ETH-PBL/open-galileo-has-gnss-platform/ublox_gnss_node/Documentation/Generate Files/BOM/Bill of Materials-ublox_gnss_node(main).xlsx

Comment | Description | Designator | Footprint | LibRef | Quantity | Manufacturer | Manufacturer Part Number | Part Number | PartNumber | Manufacturer Name | Manufacturer_Name | Supplier | Supplier Part Number
ZED-X20P-00B | u-blox X20 all-band GNSS High Precision module LGA, 250 pcs/reel | U3 | ZED-F9P | ZED-X20P-00B | 1 | u-blox | ZED-X20P-00B | ZED-F9P-00B |  |  |  | DigiKey | 672-ZED-X20P-00BCT-ND
TPS2116DRLR | 1.6-V to 5.5-V, 40-mâ„ | U13, U14 | DRL0008A-MFG | TPS2116DRLR | 2 |  | TPS2116DRLR |  |  | Texas Instruments
TPD4S012DRYR | TVS DIODE 5.5V 6SON | U9, U12 | FP-DRY0006A-MFG | CMP-0326-00038-4 | 2 |  | TPD4S012DRYR
TPD4E05U06QDQARQ1 | TVS DIODE 5.5V 14V 10USON | U5 | FP-DQA0010A-MFG | CMP-04985-000004-1 | 1 | Texas Instruments | TPD4E05U06QDQARQ1
STM32H755ZIT6U | STM32H755 MCU | IC1 | QFP50P2200X2200X160-144N | STM32H755ZIT6U | 1 |  | STM32H755ZIT6U |  |  |  | STMicroelectronics
SMCJ58CA-E3/57T | TVS DIODE 58V 93.6V DO214AB | D10 | FP-95402-MFG | CMP-02577-000016-1 | 1 | Vishay Semiconductor Diodes Division | SMCJ58CA-E3/57T
SM91072AL | Telecom Transformer 1: 1 1.4Ohm Prim. DCR 1Ohm Sec. DCR 16 Terminal Gull Wing SMD Automotive | T1 | SOIC127P950X590-16N | SM91072AL | 1 | Bourns | SM91072AL |  |  |  |  | Digikey | 118-SM91072AL-ECT-ND
47R | 47Ω ±5% 1W 2512 Thick Film Chip Resistor AEC-Q200 compliant | R52, R53 | FP-RMCF2512-MFG | CMP-26527-006410-1 | 2 | Stackpole Electronics | RMCF2512JT47R0 |  |  |  |  | Avnet | RMCF2512JT47R0
NX3215SA-32.768K-STD-MUA-14 | Crystal or Oscillator - 6pF Load | Y1 | NX3215SA32768KSTDMUA8 | NX3215SA-32.768K-STD-MUA-14 | 1 |  | NX3215SA-32.768K-STD-MUA-14 |  |  |  | NDK
MX25L51245GMI-08G | NOR Flahs 512MBit QSPI Macronix | IC3 | SOIC127P1030X265-16N | MX25L51245GMI-08G | 1 |  | MX25L51245GMI-08G |  |  |  | Macronix
MB4S | BRIDGE RECT 1P 400V 500MA 4SOIC | D11 | FP-751EP-MFG | CMP-07163-000033-1 | 1 | ON Semiconductor | MB4S
M24C64-FMN6TP | EEPROM ST 64kbit I2C | IC2 | SOIC127P600X175-8N | M24C64-FMN6TP | 1 |  | M24C64-FMN6TP |  |  |  | STMicroelectronics
M12D-04PFFR-SF7003 | Conn Circular F 4 POS Solder RA Panel Mount 4 Terminal 1 Port | X1 | M12D04PFFRSF7003 | M12D-04PFFR-SF7003 | 1 | Amphenol | M12D-04PFFR-SF7003
LSM303AGRTR | IMU ACCEL/MAG I2C/SPI 12LGA | U2 | FP-LGA-12-8487206-MFG | CMP-2000-07465-2 | 1 | STMicroelectronics | LSM303AGRTR
2,2uH, 1.2A | Inductor | L2 | LQM2MPN1R0NG0L | LQM2MPN2R2MG0L | 1 |  | LQM2MPN2R2MG0L |  |  |  | Murata Electronics
LQG15HS47NJ02D | Multilayer type RF Inductor 47nH ±5% 0.72Ω 300mA 0402 | L1 | FP-LQG15HH_02-IPC_B | CMP-06042-015783-1 | 1 | Murata | LQG15HS47NJ02D |  |  |  |  | Digikey | 490-2631-6-ND
LMR43620MC3RPERQ1 | Integrated Circuit | U6 | LMR43620MC3RPERQ1 | LMR43620MC3RPERQ1 | 1 |  | LMR43620MC3RPERQ1 |  |  |  | Texas Instruments
10uF | Capacitor 10uF 0805 | C27, C32, C33, C66, C67, C74, C75 | CAPC2013X140N | LMK212AB7106MG-T | 7 |  | LMK212AB7106MG-T |  |  |  | TAIYO YUDEN
ISOUSB111DWXR | Low emissions, full and low speed isolated USB repeater 16-SSOP -40 to 125 | U8, U11 | DWX0016A | ISOUSB111DWXR | 2 | Texas Instruments | ISOUSB111DWXR |  |  |  |  | Digikey | 296-ISOUSB111DWXRCT-ND
ISM330DHCXTR | INEMO INERTIAL MODULE: ALWAYS-ON | U1 | FP-LGA-14L-DM00249496-MFG | CMP-12177-000014-1 | 1 | STMicroelectronics | ISM330DHCXTR |  |  |  |  | Digikey | 497-19784-6-ND
10uF | CAP CER 10UF 25V X5R 0603 | C8, C62, C63, C85 | FP-GRM188-0_2-IPC_C | GRM188R61E106MA73D | 4 | Murata | GRM188R61E106MA73D |  |  |  |  | Digi-Key | 490-7202-6-ND
100nF | Capacitor 100nF 0402 - storage | C31, C55, C59, C64 | CAPC1005X55X25ML05T10 | GRM155R71H104KE14J | 4 | Murata | GRM155R71H104KE14J
DNP | Capacitor 100nF 0402 - storage | C45, C47 | CAPC1005X55X25LL05T10 | GRM155R71H104KE14J | 2 | Murata | GRM155R71H104KE14J
10nF | Capacitor 10nF/50V 0402 - storage | C36, C40, C53 | GRM15x | GRM155R71H103KA88D | 3 |  | GRM155R71H103KA88D |  |  |  | Murata Electronics
100nF | [NoValue], Capacitor 100nF 0402 - storage | C2, C3, C7, C9, C37, C41, C44, C46, C50, C88 | CAPC1005X55X25LL05T10 | CMP-2008-03928-1, GRM155R71H104KE14J | 10 | Murata | GRM155R71C104KA88J, GRM155R71H104KE14J | GRM155R71C104KA88J, [NoParam]
10uF | Capacitor 10uF 0402 - storage | C39, C43 | GRM15x | GRM155R61A106ME11D | 2 |  | GRM155R61A106ME11D |  |  |  | Murata Electronics
1uF | Capacitor 1uF/35V 0402 - storage | C38, C42 | CAPC1005X70N | GRM155R6YA105KE11D | 2 |  | GRM155R6YA105KE11D |  |  |  | Murata Electronics
1uF | CAP 1uF 0402 (1005 Metric) | C1, C4 | CAPC0402(1005)60_L | CMP-1034-02114-1 | 2 | Murata | GRM155C81C105KE11D
4.7uF/50V | Capacitor 4.7uF/50V 0805 | C56 | CAPC2012X145N | GRM21BR61H475KE51L | 1 |  | GRM21BR61H475KE51L |  |  |  | Murata Electronics
EVP-AA002K | Light Touch Switch, 100 mOhm, -40 to 85 degC, 4-Pin SMD, RoHS, Tape and Reel | SW1 | PNSC-EVPAA_V | CMP-2000-06231-1 | 1 | Panasonic | EVP-AA002K |  |  |  |  | PanasonicIndustrialDevices | P13347SDKR-ND
5k1 | Resistor 5k1 0805 | R40, R42, R43, R46, R47 | ERJUP6 | ERJ-UP6D5101V | 5 |  | ERJ-UP6D5101V |  |  |  | Panasonic
10k | Resistor 10k 0805 | R13, R14, R15, R24, R25, R26, R28 | RESC2012X70N | ERJ-6GEYJ103V | 7 |  | ERJ-6GEYJ103V |  |  |  | Panasonic
10k | Resistor 10k 0402 | R41, R48, R49 | RESC1005X40X25ML05T05 | CMP-2002-00433-1 | 3 | Panasonic | ERJ-2GEJ103X
75R | Resistor 75R 0805 | R36, R37 | RESC2013X60X40NL20T25 | CMP-2001-00665-1 | 2 |  | ERA6AEB750V | ERA6AEB750V
2k2 | Resistor 2k2 0603 | R29, R30, R31, R35 | RESC2013X60X40LL20T25 | CMP-2001-00613-1 | 4 | Panasonic | ERA6AEB222V
6.8uH | Inductor 6.8uH 2.55A 43.5 MOHM | L3 | DR736R8R | DR73-6R8-R | 1 |  | DR73-6R8-R |  |  |  | Eaton
DP83826ERHBR | Ethernet Transceiver, 1-Trnsvr, PQCC32 | U4 | QFN_ERHBR_TEX | DP83826ERHBR | 1 | Texas Instruments | DP83826ERHBR |  |  |  |  | Digikey | 296-DP83826ERHBRCT-ND
0R | Resistor 0R 0402 | R2, R16, R17, R18, R22, R27, R38, R44, R51 | RESC1005X40X25LL05T10 | CMP-2002-03041-1 | 9 | Vishay Dale | CRCW04020000Z0EDHP | CRCW04020000Z0EDHP
0R | Resistor 0R 0402 | R32 | RESC1005X40X25NL05T10 | CMP-009-00183-1 | 1 | Vishay Dale | CRCW04020000Z0EDHP
DNP | Resistor 0R 0402 | R33 | RESC1005X40X25NL05T10 | CMP-009-00183-1 | 1 | Vishay Dale | CRCW04020000Z0EDHP
DNP | Resistor 0R 0402 | R39, R50 | RESC1005X40X25LL05T10 | CMP-2002-03041-1 | 2 | Vishay Dale | CRCW04020000Z0EDHP | CRCW04020000Z0EDHP
100k | 100K 0.1W 1% 0603 (1608 Metric) SMD | R54, R55 | RESC0603(1608)_N | CMP-1012-00736-1 | 2 | Vishay, [NoParam] | CRCW0603100KFKTC, [NoParam] |  |  |  |  | DigiKey, [NoParam] | CRCW0603100KFKTC-ND, [NoParam]
6k49 | Resistor 6k49 0402 1% | R34 | RESC1005X40X25NL05T05 | CMP-2002-00186-1 | 1 | Vishay Dale | CRCW04026K49FKED
10R | Chip Resistor, 10 Ohm, +/- 1%, 0.1 W, -55 to 155 degC, 0603 (1608 Metric), RoHS, Tape and Reel | R3 | RESC1608X55X25NL10T15 | CMP-1659-00008-4 | 1 | Yageo | CR0603-FX-10R0ELF |  |  |  |  | Digikey | CR0603-FX-10R0ELFCT-ND
1nF/2kV | Capacitor 1nF/2kV 3216 Isolated GND Loop Cap | C54 | CAPC3216X180N | CL31B102KJHNNNE | 1 |  | CL31B102KJHNNNE |  |  |  | SAMSUNG
DNP | Capacitor 1nF/2kV 3216 Isolated GND Loop Cap | C73, C81 | CAPC3216X180N | CL31B102KJHNNNE | 2 |  | CL31B102KJHNNNE |  |  |  | SAMSUNG
4.7uF | Capacitor 4.7uF 0603 | C68, C76 | CAPC1608X95N | CL10B475KQ8NQNC | 2 |  | CL10B475KQ8NQNC |  |  |  | SAMSUNG
1uF | Capacitor 1uF 0603 | C10, C12, C14 | CAPC1608X90N | CL10B105KP8NNNC | 3 |  | CL10B105KP8NNNC |  |  |  | SAMSUNG
220nF |  | C5 | CAPC1005X55X25NL05T05 | CMP-1034-02087-2 | 1 | Samsung | CL05B224KO5NNNC |  |  |  |  | Digikey | 1276-1176-1-ND
100nF | Capacitor 100nF 0603 | C11, C13, C16, C17, C18, C19, C20, C21, C22, C23, C24, C25, C28, C29, C30, C86, C87 | CAPC1608X90N | CC0603KRX7R7BB104 | 17 |  | CC0603KRX7R7BB104 |  |  |  | YAGEO
1uF/50V | Capacitor 1uF/50V 0801 | C57, C58, C65 | CAPC3216X110X50LL20T25 | CMP-2000-06011-1 | 3 | Kemet | C1206C105K5RACTU
1nF | Capacitor 1nF 0805 | C69, C70, C71, C72, C77, C78, C79, C80 | FP-C0805C-DN-MFG | CMP-2007-00235-2 | 8 | KEMET | C0805C102J5GACTU
100nF | Capacitor 100nF 0603 | C82, C83 | FP-C0603C-CF-MFG | CMP-2006-03061-2 | 2 | KEMET | C0603C104K5RACTU
10nF/200V | CAP 10nF 200V ±10% 0603 (1608 Metric) Thickness 1mm SMD | C51, C52 | CAPC0603(1608)100_L | CMP-1035-02328-1 | 2 | Yageo Group | C0603C103K2RAC
22pF | Capacitor 22pF 0402 | C48, C49 | C0402C104J4RACTU | C0402C220K5GACTU | 2 |  | C0402C220K5GACTU |  |  |  | KEMET
BLM18KG601SN1D | Chip Ferrite Bead, 0603, 600Ω @ 100MHz, 0.15Ω, 25%, 1.3A | FB1, FB2, FB3, FB4, FB5, FB6 | FP-BLM18-0_15-t0_8-IPC_A | CMP-0686-00581-3 | 6 |  | BLM18KG601SN1D, [NoParam]
AG9905-MTB | Power over Ethernet - PoE PD Module, Isolated DC-DC converter, IEEE802.3af compliant, Over Temp. Protection, Ind Temp. Range, Small Footprint, SMT. (Blocks not pins). | B1 | AG9905MTB | AG9905-MTB | 1 |  | AG9905-MTB |  |  | Silvertel
ABM8AIG-25.000MHZ-12-2Z-T3 | Crystal 25MHz ±20ppm (Tol) ±50ppm (Stability) 12pF FUND 50Ω Automotive 4-Pin Ultra Mini-CSMD T/R | Y2 | FP-ABM8AIG-MFG | CMP-27762-004325-2 | 1 |  | ABM8AIG-25.000MHZ-12-2Z-T3
12402012E212A | USB2.0, Type C, Top mount, CH 1.68mm, Dual Row SMT | J2, J3 | AMPHENOL_12402012E212A | 12402012E212A | 2 |  | 12402012E212A
220pF | Capacitor 220pF 0603 | C26 | CAPC1608X87N | 0603B221K500CT | 1 |  | 0603B221K500CT |  |  |  | Walsin Technology Corporation
2k2 |  | R1 | RESC1005X40X25NL05T10 | CMP-2002-07567-1 | 1 | Yageo / Phycomp |  | RC0402FR-072K2L
4.7k |  | R19, R20, R21, R23, R58, R59, R60, R61 | RESC1005X40X25LL05T05 | CMP-1011-00090-2 | 8 | Vishay Dale |  | CRCW04024K70JNTD
5.1pF |  | C34, C35 | CAPC1005X55X25NL05T10 | CMP-2008-04393-1 | 2 | Murata |  | GRM1555C1H5R1CA01D
22uF |  | C15, C60, C61 | CAPC2013X152X50ML20T25 | CMP-2007-04522-1 | 3 | AVX Interconnect / Elco |  | 0805ZD226MAT2A
33k |  | R56, R57 | RESC3116X65X40LL10T20 | CMP-2003-03510-1 | 2 | Yageo |  | RC1206JR-1033KL
100uF | Aluminum Electrolytic Capacitor, UD Series, Low Impedance, 100 uF, 25 V, + / - 20%, -55 to 105 degC, Chip Type, 6.3 x 7.7 mm D x L, Pb-Free, Reel | C84 | NIC-CAPA2-6.3X7.7_V | CMP-0687-00063-1 | 1 | Nichicon |  |  | UUD1E101MCL1GS
330R | 330R 0.063W 5% 0402 (1005 Metric) SMD | R4, R5, R6, R7, R8, R9, R10, R11, R12 | RESC0402(1005)_M | CMP-1011-00062-1 | 9 |  |  |  |  |  |  | DigiKey | CRCW0402330RJNTD-ND
LED Green | WURTH ELEKTRONIK - 150060VS75000 - LED, Green, SMD, 0603, 30 mA, 2 V, 570 nm | D1, D2, D5, D8 | WL-SMCW_0603_150060xx75000 | CMP-1426-00006-7 | 4 |  |  |  |  |  |  | RS | 8154215P
LED Red | LED Low-Power Uni-Color Red 630nm 2V 2-Pin Chip 0603(1608Metric) T/R | D4, D7 | WL-SMCW_0603_150060xx75000 | CMP-1426-00001-4 | 2 |  |  |  |  |  |  | Farnell | 150060RS75000
LED Yellow | WL-SMCW SMT Mono-Color Chip LED Waterclear | D3, D6, D9 | WL-SMCW_0603_150060xx75000 | CMP-1426-00005-3 | 3 |  |  |  |  |  |  | Farnell | 150060YS75000
MIKROBUS HOST CONN. | mikroBUS Host Socket | MIKROBUS 1 | MIKROBUS HOST CONN. SMD | MIKROBUS HOST CONN._1 | 1 |  |  |  |  |  |  | DigiKey | 1471-MIKROE-5210-ND
SMA-J-P-H-ST-EM1 | CONN SMA JACK STR 50OHM EDGE MNT | J1 | FP-SMA-J-P-H-ST-EM1-MFG | CMP-02754-000006-1 | 1 |  |  |  |  |  |  | Avnet | SMA-J-P-H-ST-EM1
TDN 5-0911WISM | TDN 5-0911WISM DC-DC Converter, 5V, 1A; No. of Outputs: 1 Output; Output Power Max: 5W; Voltage - 1: 5V; Current 1: 1A; | U7, U10 | TDN 5WISM SINGLE_TRP | TDN 5-0911WISM | 2 |  |  |  |  |  |  | DigiKey | TDN5-0911WISM-ND
testpoint |  | *7, *8, *10, *11, *13, *14, *15, *16, *17, *18, *19, *20, *21, *22, *24, *25, *26, *27, *28, *29, 2, 3, 4, 5, 6, 7, r | testpoint | testpoint | 27
