ETH-PBL/open-galileo-has-gnss-platform/ublox_gnss_node/Documentation/Generate Files/BOM/FINAL BOM/Bill of Materials-ublox_gnss_node - reduced replacements (DigiKey).xlsx

Quantity | Merged Name | Merged Number | Old PART | COMMENT | Original Part | Original Manufacturer | Matched Part Number | Matched Manufacturer | Part Match | Description | Quantity | Selected Offers | Selected Distributor | Selected Distributor SKU | Selected Offers (Distributor Link) | Stock | Unit Price, $ | Total Quantity | Total Price
2 |  | TPD4S012DRYR |  |  | TPD4S012DRYR |  | TPD4S012DRYR | Texas Instruments | Exact | IC 4CH ESD SOLUTION W/CLAMP 6SON / ESD Suppressor Diode Diode Array Uni-Dir 5.5V 6-Pin USON T/R | 2 | DigiKey 296-24244-1-ND (https://octopart.com/opatz8j6/a1) | DigiKey | 296-24244-1-ND (https://octopart.com/opatz8j6/a1) | https://octopart.com/opatz8j6/a1 | 11349 | 0.97 | 2 | 1.94
1 | STMicroelectronics | STM32H755ZIT3 | STM32H755ZIT6 | 3 has extended temp range | STM32H755ZIT3 | STMicroelectronics | STM32H755ZIT3 | STMicroelectronics | Exact | MCU 32-bit ARM Cortex M4/ARM Cortex M7 RISC 2MB Flash 1.8V/2.5V/3.3V 144-Pin LQFP Tray | 1 | DigiKey 497-STM32H755ZIT3-ND (https://octopart.com/opatz8j6/a1) | DigiKey | 497-STM32H755ZIT3-ND (https://octopart.com/opatz8j6/a1) | https://octopart.com/opatz8j6/a1 | 441 | 18.77 | 1 | 18.77
2 | SAMSUNG | CL10B475KQ8NQNC |  |  | CL10B475KQ8NQNC | SAMSUNG | CL10B475KQ8NQNC | SAMSUNG | Exact | 6.3V 4.7uF X7R 卤10% 0603 Multilayer Ceramic Capacitors MLCC - SMD/SMT ROHS | 2 | DigiKey 1276-2087-1-ND (https://octopart.com/opatz8j6/a1) | DigiKey | 1276-2087-1-ND (https://octopart.com/opatz8j6/a1) | https://octopart.com/opatz8j6/a1 | 624974 | 0.14 | 2 | 0.28
2 |  | 12402012E212A |  |  | 12402012E212A |  | 12402012E212A | Amphenol | Exact | USB Connector, USB Type C, USB 2.0, Receptacle, 24 Ways, Surface Mount, Through Hole Mount | 2 | DigiKey 664-12402012E212ACT-ND (https://octopart.com/opatz8j6/a1) | DigiKey | 664-12402012E212ACT-ND (https://octopart.com/opatz8j6/a1) | https://octopart.com/opatz8j6/a1 | 17603 | 0.67 | 2 | 1.34
2 | Yageo | RC1206JR-1033KL |  |  | RC1206JR-1033KL | Yageo | RC1206JR-1033KL | Yageo | Exact | Fixed Resistor, Metal Glaze/thick Film, 0.25W, 33000ohm, 200V, 5% +/-Tol, 100ppm/Cel, Surface Mount, 1206 | 2 | DigiKey 13-RC1206JR-1033KLCT-ND (https://octopart.com/opatz8j6/a1) | DigiKey | 13-RC1206JR-1033KLCT-ND (https://octopart.com/opatz8j6/a1) | https://octopart.com/opatz8j6/a1 | 18635 | 0.1 | 2 | 0.2
2 | Farnell | 150060RS75000 |  |  | 150060RS75000 | Farnell | 150060RS75000 | Wurth Elektronik | Similar | LED Low-Power Uni-Color Red 630nm 2V 2-Pin Chip 0603(1608Metric) T/R | 2 | DigiKey 732-4978-1-ND (https://octopart.com/opatz8j6/a1) | DigiKey | 732-4978-1-ND (https://octopart.com/opatz8j6/a1) | https://octopart.com/opatz8j6/a1 | 352667 | 0.15 | 2 | 0.3
3 | Farnell | 150060YS75000 |  |  | 150060YS75000 | Farnell | 150060YS75000 | Wurth Elektronik | Similar | LED YELLOW CLEAR 0603 SMD / Yellow 590nm LED Indication - Discrete 2V 0603 (1608 Metric) | 3 | DigiKey 732-4981-1-ND (https://octopart.com/opatz8j6/a1) | DigiKey | 732-4981-1-ND (https://octopart.com/opatz8j6/a1) | https://octopart.com/opatz8j6/a1 | 127202 | 0.15 | 3 | 0.45
1 | Avnet | SMA-J-P-H-ST-EM1 |  |  | SMA-J-P-H-ST-EM1 | Avnet | SMA-J-P-H-ST-EM1 | Samtec | Similar | RF Connectors / Coaxial Connectors 6 GHz, 50 Ohm SMA Jack or Plug, Cable Connector | 1 | DigiKey SAM8857-ND (https://octopart.com/opatz8j6/a1) | DigiKey | SAM8857-ND (https://octopart.com/opatz8j6/a1) | https://octopart.com/opatz8j6/a1 | 94715 | 2.65 | 1 | 2.65
2 | DigiKey | TDN 5-0911WISM |  |  | TDN 5-0911WISM | DigiKey | TDN 5-0911WISM | Traco Power | Similar | DC-DC Regulated Power Supply Module, 1 Output, 5W, Hybrid | 2 | DigiKey TDN5-0911WISM-ND (https://octopart.com/opatz8j6/a1) | DigiKey | TDN5-0911WISM-ND (https://octopart.com/opatz8j6/a1) | https://octopart.com/opatz8j6/a1 | 59 | 29.12 | 2 | 58.24
