ETH-PBL/open-galileo-has-gnss-platform/(list of files, drawings)

Other design files:
ublox_gnss_node/Schematic/Copy of MCU.SchDoc
ublox_gnss_node/Schematic/DCDC_Converters.SchDoc
ublox_gnss_node/Schematic/ETH.SchDoc
ublox_gnss_node/Schematic/GNSS_ZED-X20P.SchDoc
ublox_gnss_node/Schematic/IndicatorLEDs.SchDoc
ublox_gnss_node/Schematic/MAIN.SchDoc
ublox_gnss_node/Schematic/MCU.SchDoc
ublox_gnss_node/Schematic/Memory.SchDoc
ublox_gnss_node/Schematic/Mikro_Bus.SchDoc
ublox_gnss_node/Schematic/POE_PMUX.SchDoc
ublox_gnss_node/Schematic/SENS_MEMS.SchDoc
ublox_gnss_node/Schematic/USB_C_GNSS.SchDoc
ublox_gnss_node/Schematic/USB_C_MCU.SchDoc
ublox_gnss_node/ublox_gnss_node.PcbDoc
ublox_gnss_node/ublox_gnss_node.PrjPcb
