ETH-PBL/open-galileo-has-gnss-platform/firmware/firmware.ioc

Mcu.UserName=STM32H755ZITx
PA0.GPIO_Label=MB_ADC
PA0.Signal=ADC1_INP16
PA1.Signal=ETH_REF_CLK
PA11.Signal=USB_OTG_FS_DM
PA12.Signal=USB_OTG_FS_DP
PA2.Signal=ETH_MDIO
PA3.GPIO_Label=GNSS_TIMEPULSE
PA3.Signal=S_TIM2_CH4
PA7.Signal=ETH_CRS_DV
PA8.Signal=I2C3_SCL
PA9.Signal=USB_OTG_FS_VBUS
PB0.GPIO_Label=MB_RST
PB0.Signal=GPIO_Output
PB10.Signal=SPI2_SCK
PB12.GPIO_Label=SPI_CS_MB
PB12.Signal=GPIO_Output
PB13.Signal=ETH_TXD1
PB14.GPIO_Label=MCU_LED_Red
PB14.Signal=GPIO_Output
PB15.Signal=SPI2_MOSI
PB2.Signal=SPI3_MOSI
PC1.Signal=ETH_MDC
PC10.Signal=SPI3_SCK
PC11.Signal=SPI3_MISO
PC12.Signal=UART5_TX
PC13.GPIO_Label=GNSS_EXTINT
PC13.Signal=GPXTI13
PC2_C.Signal=SPI2_MISO
PC4.Signal=ETH_RXD0
PC5.Signal=ETH_RXD1
PC8.GPIO_Label=MB_INT
PC8.Signal=GPXTI8
PC9.Signal=I2C3_SDA
PD13.GPIO_Label=SPI_CS_XL
PD13.Signal=GPIO_Output
PD14.GPIO_Label=MB_PWM
PD14.Signal=S_TIM4_CH3
PD15.GPIO_Label=QUADSPI_RST
PD15.Signal=GPIO_Output
PD2.Signal=UART5_RX
PD7.GPIO_Label=GNSS_RESET_N
PD7.Signal=GPIO_Output
PD8.Signal=USART3_TX
PD9.Signal=USART3_RX
PE0.GPIO_Label=ETH_RST
PE0.Signal=GPIO_Output
PE1.GPIO_Label=MCU_LED_Yellow
PE1.Signal=GPIO_Output
PE2.GPIO_Label=GNSS_RTK_STAT
PE2.Signal=GPXTI2
PE3.GPIO_Label=SENS_ISM_INT
PE3.Signal=GPXTI3
PE4.GPIO_Label=SENS_LSM_INT
PE4.Signal=GPXTI4
PE5.GPIO_Label=SENS_LSM_INTM
PE5.Signal=GPXTI5
PE6.GPIO_Label=GEOFENCE_STAT
PE6.Signal=GPXTI6
PF10.Signal=QUADSPI_CLK
PF14.GPIO_Label=MB_I2C_SCL
PF14.Signal=I2C4_SCL
PF15.GPIO_Label=MB_I2C_SDA
PF15.Signal=I2C4_SDA
PF6.Signal=QUADSPI_BK1_IO3
PF7.Signal=QUADSPI_BK1_IO2
PF8.Signal=QUADSPI_BK1_IO0
PF9.Signal=QUADSPI_BK1_IO1
PG11.Signal=ETH_TX_EN
PG13.Signal=ETH_TXD0
PG6.Signal=QUADSPI_BK1_NCS
PG7.GPIO_Label=SPI_CS_MAG
PG7.Signal=GPIO_Output
PG8.GPIO_Label=SPI_CS_ISM
PG8.Signal=GPIO_Output
PG9.GPIO_Label=MCU_LED_Green
PG9.Signal=GPIO_Output
