ETH-PBL/open-galileo-has-gnss-platform/firmware/CM7/Core/Src/main.c

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
/* Includes ------------------------------------------------------------------*/
#include "main.h"
#include "cmsis_os.h"
#include "dma.h"
#include "i2c.h"
#include "lwip.h"
#include "quadspi.h"
#include "usb_device.h"
#include "gpio.h"

/* USER CODE BEGIN Includes */
#include "shared_memory.h"
/* USER CODE END Includes */

/* USER CODE BEGIN PD */

/* DUAL_CORE_BOOT_SYNC_SEQUENCE: Define for dual core boot synchronization    */
/*                             demonstration code based on hardware semaphore */
/* This define is present in both CM7/CM4 projects                            */
/* To comment when developping/debugging on a single core                     */
#define DUAL_CORE_BOOT_SYNC_SEQUENCE

#if defined(DUAL_CORE_BOOT_SYNC_SEQUENCE)
#ifndef HSEM_ID_0
#define HSEM_ID_0 (0U) /* HW semaphore 0*/
#endif
#endif /* DUAL_CORE_BOOT_SYNC_SEQUENCE */

/* USER CODE END PD */


void SystemClock_Config(void);
static void MPU_Config(void);
void MX_FREERTOS_Init(void);
/* USER CODE BEGIN PFP */
static void MPU_Config_User(void);
/* USER CODE END PFP */

/**
  * @brief  The application entry point.
  * @retval int
  */
int main(void)
{

/* USER CODE BEGIN Boot_Mode_Sequence_0 */
#if defined(DUAL_CORE_BOOT_SYNC_SEQUENCE)
  int32_t timeout;
#endif /* DUAL_CORE_BOOT_SYNC_SEQUENCE */
/* USER CODE END Boot_Mode_Sequence_0 */

  /* MPU Configuration--------------------------------------------------------*/
  MPU_Config();

/* USER CODE BEGIN Boot_Mode_Sequence_1 */
  MPU_Config_User(); /* override CubeMX's broken MPU_Config() which omits .Number */
#if defined(DUAL_CORE_BOOT_SYNC_SEQUENCE)
  /* Wait until CPU2 boots and enters in stop mode or timeout*/
  timeout = 0xFFFF;
  while ((__HAL_RCC_GET_FLAG(RCC_FLAG_D2CKRDY) != RESET) && (timeout-- > 0))
    ;
  if (timeout < 0)
  {
    Error_Handler();
  }
#endif /* DUAL_CORE_BOOT_SYNC_SEQUENCE */
/* USER CODE END Boot_Mode_Sequence_1 */
  /* MCU Configuration--------------------------------------------------------*/

  /* Reset of all peripherals, Initializes the Flash interface and the Systick. */
  HAL_Init();

  /* Configure the system clock */
  SystemClock_Config();
/* USER CODE BEGIN Boot_Mode_Sequence_2 */
  /* Initialize the Shared Memory after Power and Clocks are stabilized,
     but before waking the CM4 */
  SharedMemory_Init();

#if defined(DUAL_CORE_BOOT_SYNC_SEQUENCE)
  /* When system initialization is finished, Cortex-M7 will release Cortex-M4 by means of
  HSEM notification */
  /*HW semaphore Clock enable*/
  __HAL_RCC_HSEM_CLK_ENABLE();
  /*Take HSEM */
  HAL_HSEM_FastTake(HSEM_ID_0);
  /*Release HSEM in order to notify the CPU2(CM4)*/
  HAL_HSEM_Release(HSEM_ID_0, 0);
  /* wait until CPU2 wakes up from stop mode */
  timeout = 0xFFFF;
  while ((__HAL_RCC_GET_FLAG(RCC_FLAG_D2CKRDY) == RESET) && (timeout-- > 0))
    ;
  if (timeout < 0)
  {
    Error_Handler();
  }
#endif /* DUAL_CORE_BOOT_SYNC_SEQUENCE */
/* USER CODE END Boot_Mode_Sequence_2 */

  /* Initialize all configured peripherals */
  MX_GPIO_Init();
  MX_DMA_Init();
  MX_I2C3_Init();
  MX_QUADSPI_Init();
  /* USER CODE BEGIN 2 */
  // test code to check that i can program the board, should blink led

  /*while (1)
  {
    // Use the defined Port and Pin macros
    HAL_GPIO_TogglePin(MCU_LED_Yellow_GPIO_Port, MCU_LED_Yellow_Pin);
    HAL_Delay(500);
  }
  */

  /* USER CODE END 2 */

  /* Init scheduler */
  osKernelInitialize();  /* Call init function for freertos objects (in cmsis_os2.c) */
  MX_FREERTOS_Init();

  /* Start scheduler */
  osKernelStart();

  /* We should never get here as control is now taken by the scheduler */

  /* Infinite loop */
  /* USER CODE BEGIN WHILE */
  while (1)
  {
    /* USER CODE END WHILE */

    /* USER CODE BEGIN 3 */
  }
  /* USER CODE END 3 */
}

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
/* USER CODE BEGIN 4 */

/* Region 0: SRAM1+SRAM2 (0x30000000, 256KB) — ETH DMA descriptors and Rx pool.
   Must be non-cacheable so the CM7 D-cache never hides DMA writes from the CPU
   or CPU writes from the DMA.
   Region 1: SRAM4 (0x38000000, 64KB) — D3 domain shared memory.
   NOTE: CubeMX does not emit .Number assignments, so both regions end up as
   region 0 and the second call silently overwrites the first. This function
   replaces the CubeMX-generated stub below; if CubeMX regenerates main.c,
   delete the generated MPU_Config body and uncomment the call to this one,
   or just run: git restore CM7/Core/Src/main.c */
static void MPU_Config_User(void)
{
  MPU_Region_InitTypeDef MPU_InitStruct = {0};

  HAL_MPU_Disable();

  MPU_InitStruct.Number            = MPU_REGION_NUMBER0;
  MPU_InitStruct.Enable            = MPU_REGION_ENABLE;
  MPU_InitStruct.BaseAddress       = 0x30000000;
  MPU_InitStruct.Size              = MPU_REGION_SIZE_256KB;
  MPU_InitStruct.SubRegionDisable  = 0x0;
  MPU_InitStruct.TypeExtField      = MPU_TEX_LEVEL1;
  MPU_InitStruct.AccessPermission  = MPU_REGION_PRIV_RW;
  MPU_InitStruct.DisableExec       = MPU_INSTRUCTION_ACCESS_ENABLE;
  MPU_InitStruct.IsShareable       = MPU_ACCESS_NOT_SHAREABLE;
  MPU_InitStruct.IsCacheable       = MPU_ACCESS_NOT_CACHEABLE;
  MPU_InitStruct.IsBufferable      = MPU_ACCESS_NOT_BUFFERABLE;
  HAL_MPU_ConfigRegion(&MPU_InitStruct);

  MPU_InitStruct.Number            = MPU_REGION_NUMBER1;
  MPU_InitStruct.BaseAddress       = 0x38000000;
  MPU_InitStruct.Size              = MPU_REGION_SIZE_64KB;
  MPU_InitStruct.TypeExtField      = MPU_TEX_LEVEL1;
  MPU_InitStruct.AccessPermission  = MPU_REGION_PRIV_RW;
  MPU_InitStruct.DisableExec       = MPU_INSTRUCTION_ACCESS_DISABLE;
  MPU_InitStruct.IsShareable       = MPU_ACCESS_SHAREABLE;
  MPU_InitStruct.IsCacheable       = MPU_ACCESS_NOT_CACHEABLE;
  MPU_InitStruct.IsBufferable      = MPU_ACCESS_NOT_BUFFERABLE;
  HAL_MPU_ConfigRegion(&MPU_InitStruct);

  HAL_MPU_Enable(MPU_PRIVILEGED_DEFAULT);
}

/* USER CODE END 4 */

 /* MPU Configuration */

void MPU_Config(void)
{

  /* Disables the MPU */
  HAL_MPU_Disable();

  /* Enables the MPU */
  HAL_MPU_Enable(MPU_PRIVILEGED_DEFAULT);

}

/**
  * @brief  Period elapsed callback in non blocking mode
  * @note   This function is called  when TIM7 interrupt took place, inside
  * HAL_TIM_IRQHandler(). It makes a direct call to HAL_IncTick() to increment
  * a global variable "uwTick" used as application time base.
  * @param  htim : TIM handle
  * @retval None
  */
void HAL_TIM_PeriodElapsedCallback(TIM_HandleTypeDef *htim)
{
  if (htim->Instance == TIM7)
  {
    HAL_IncTick();
  }
}

/**
  * @brief  This function is executed in case of error occurrence.
  * @retval None
  */
void Error_Handler(void)
{
  /* USER CODE BEGIN Error_Handler_Debug */
  /* User can add his own implementation to report the HAL error return state */
  __disable_irq();
  while (1)
  {
  }
  /* USER CODE END Error_Handler_Debug */
}
#ifdef USE_FULL_ASSERT
/**
  * @brief  Reports the name of the source file and the source line number
  *         where the assert_param error has occurred.
  * @param  file: pointer to the source file name
  * @param  line: assert_param error line source number
  * @retval None
  */
void assert_failed(uint8_t *file, uint32_t line)
{
  /* USER CODE BEGIN 6 */
  /* User can add his own implementation to report the file name and line number,
     ex: printf("Wrong parameters value: file %s on line %d\r\n", file, line) */
  /* USER CODE END 6 */
}
#endif /* USE_FULL_ASSERT */
